Kilill/HID_SteeringWheel/Docs/Scematic.pdf

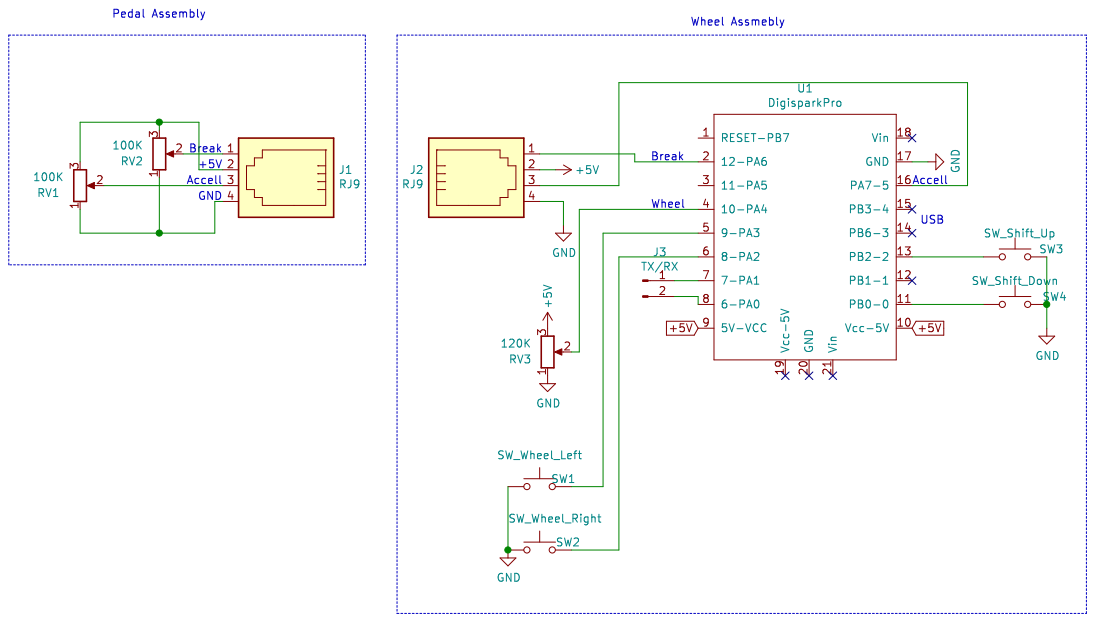
[picture p3: page 1]
